plan-zero/zyraxes-rover/README.md

# Zyraxes Rover 

This is a platform that will be used for educational purposes and/or other projects.
This is inspired by the existing [JPL’s rover](https://github.com/nasa-jpl/open-source-rover).
