plan-zero/zyraxes-rover/hw/Schematic_zyraxes-motor-driver-v4.2.pdf

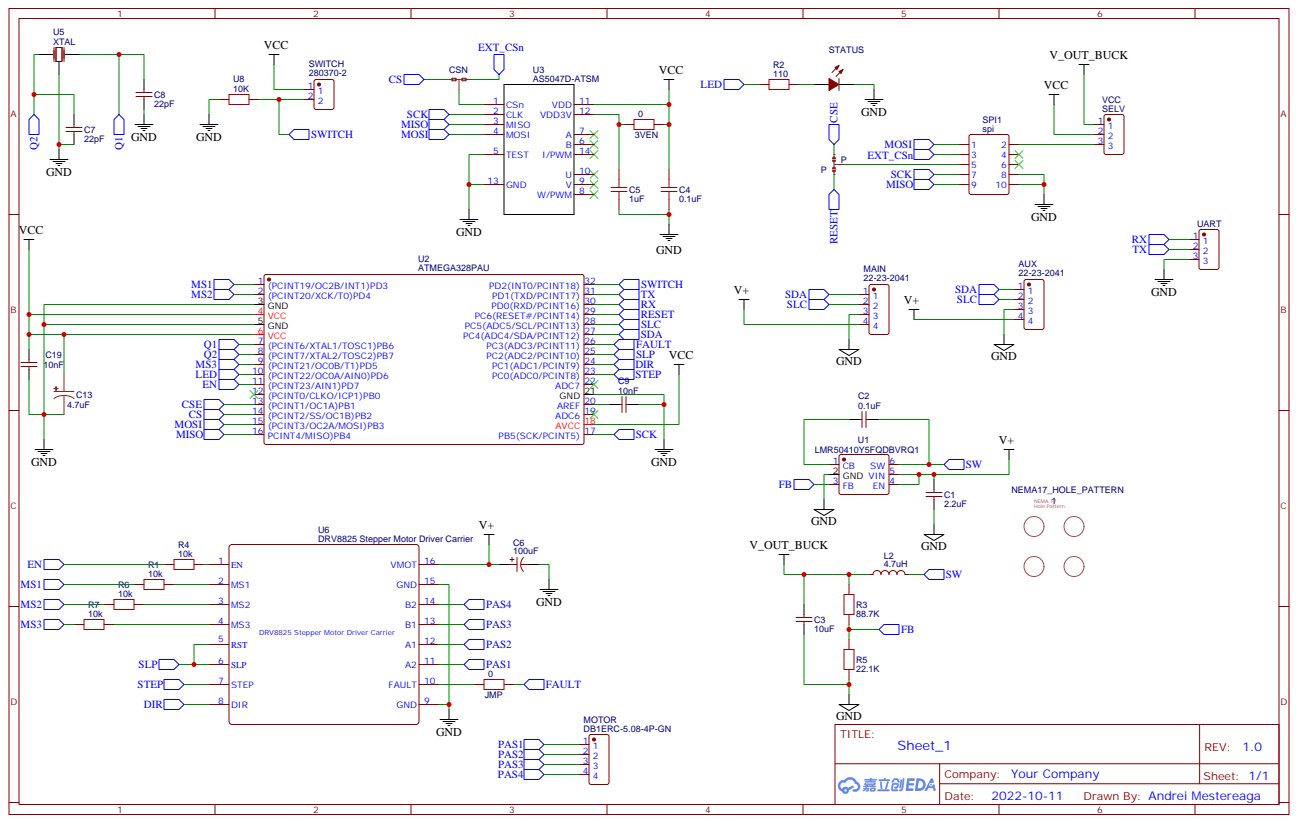
[picture p1: page 1]

DRV8825 Stepper Motor Driver Carrier

Drawn By: Andrei Mestereaga
