plan-zero/zyraxes-rover/hw/Schematic_mechaduino_v1.0.0.pdf

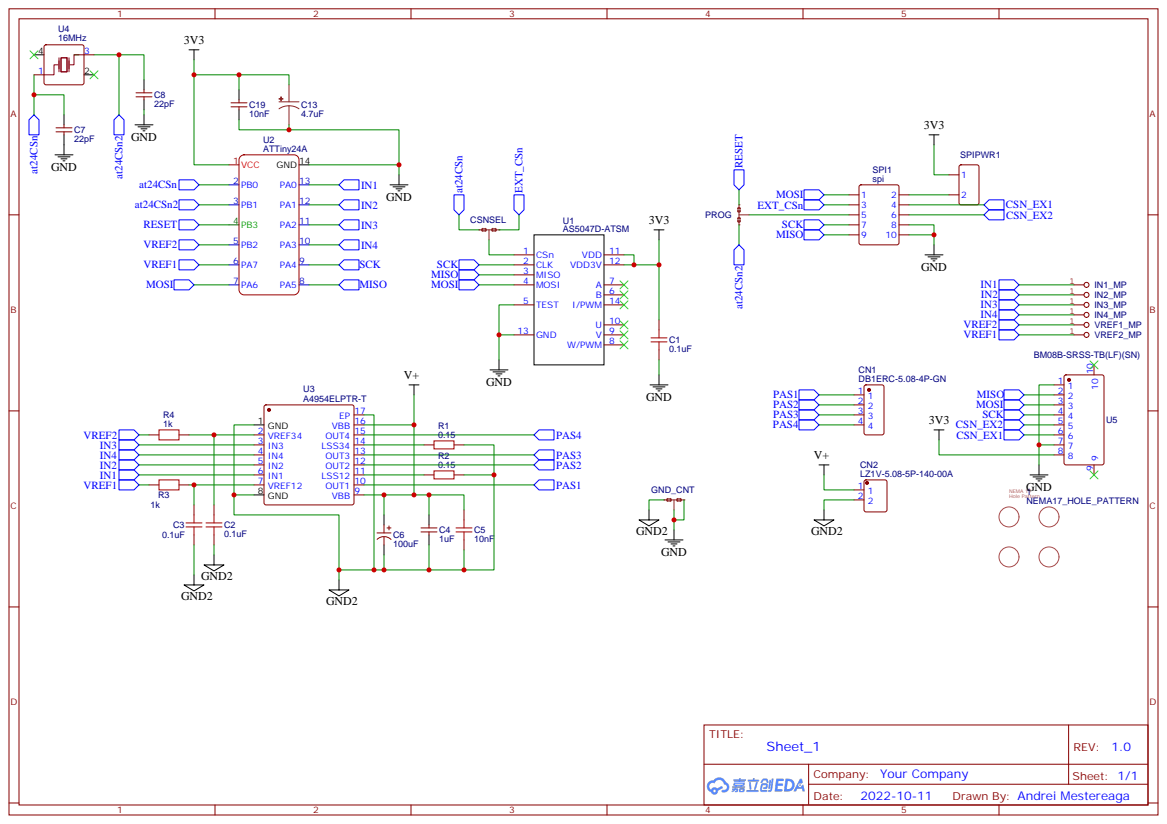
[picture p2: page 1]

BM08B-SRSS-TB(LF)(SN)

Drawn By: Andrei Mestereaga
