plan-zero/zyraxes-rover/hw/Schematic_mechaduino_2022-10-12-1.pdf

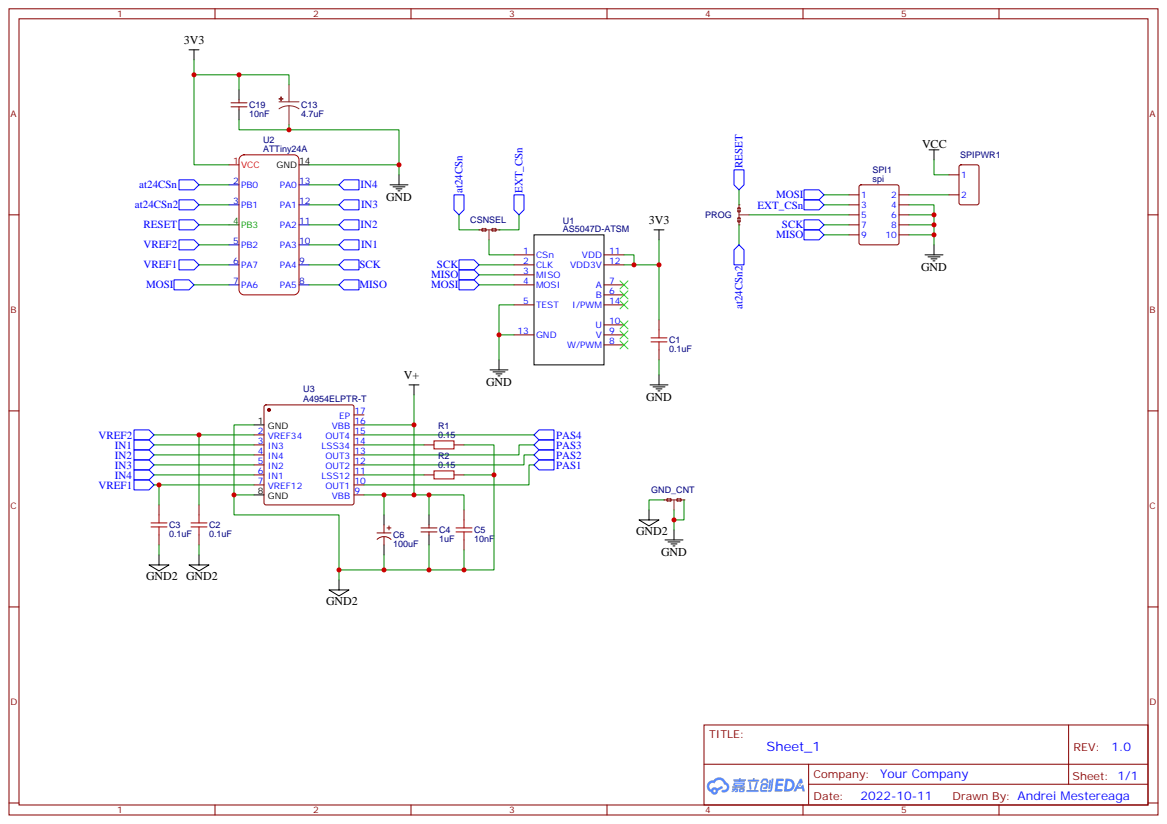
[picture p3: page 1]

Drawn By: Andrei Mestereaga
