plan-zero/zyraxes-rover/hw/powerboard/Schematic_AutomationFarm-powerModule_2022-10-02.pdf

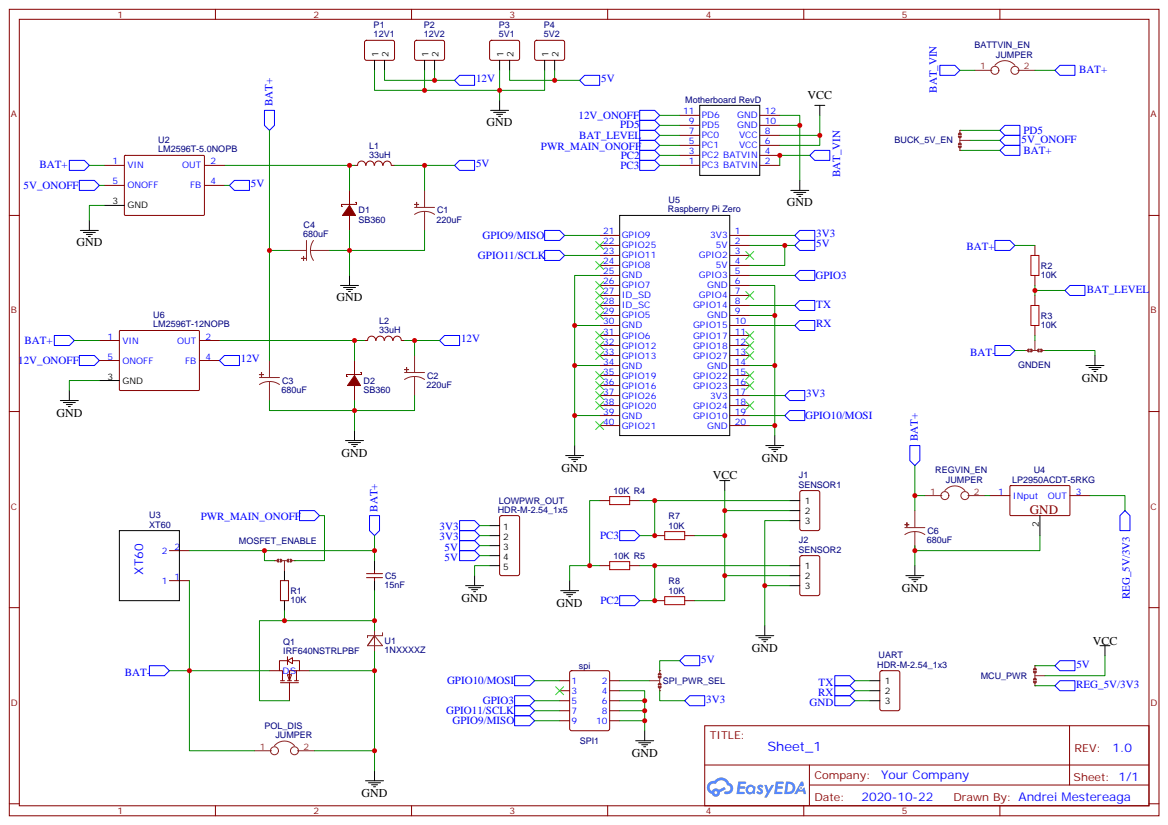
[picture p4: page 1]

Drawn By: Andrei Mestereaga
