plan-zero/zyraxes-rover/hw/Schematic_zyraxes-motor-driver-v3.5.pdf

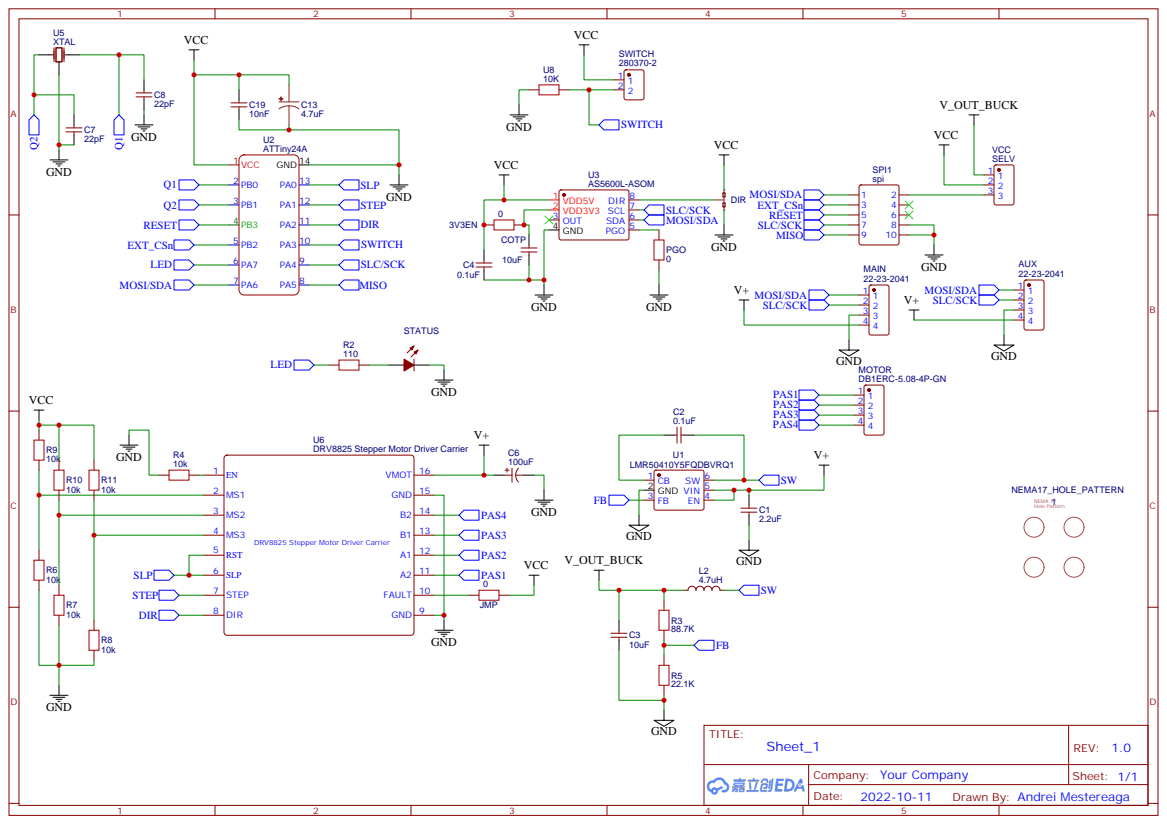
[picture p5: page 1]

DRV8825 Stepper Motor Driver Carrier

Drawn By: Andrei Mestereaga
