plan-zero/zyraxes-rover/hw/Schematic_mechaduino_v0.0.4.pdf

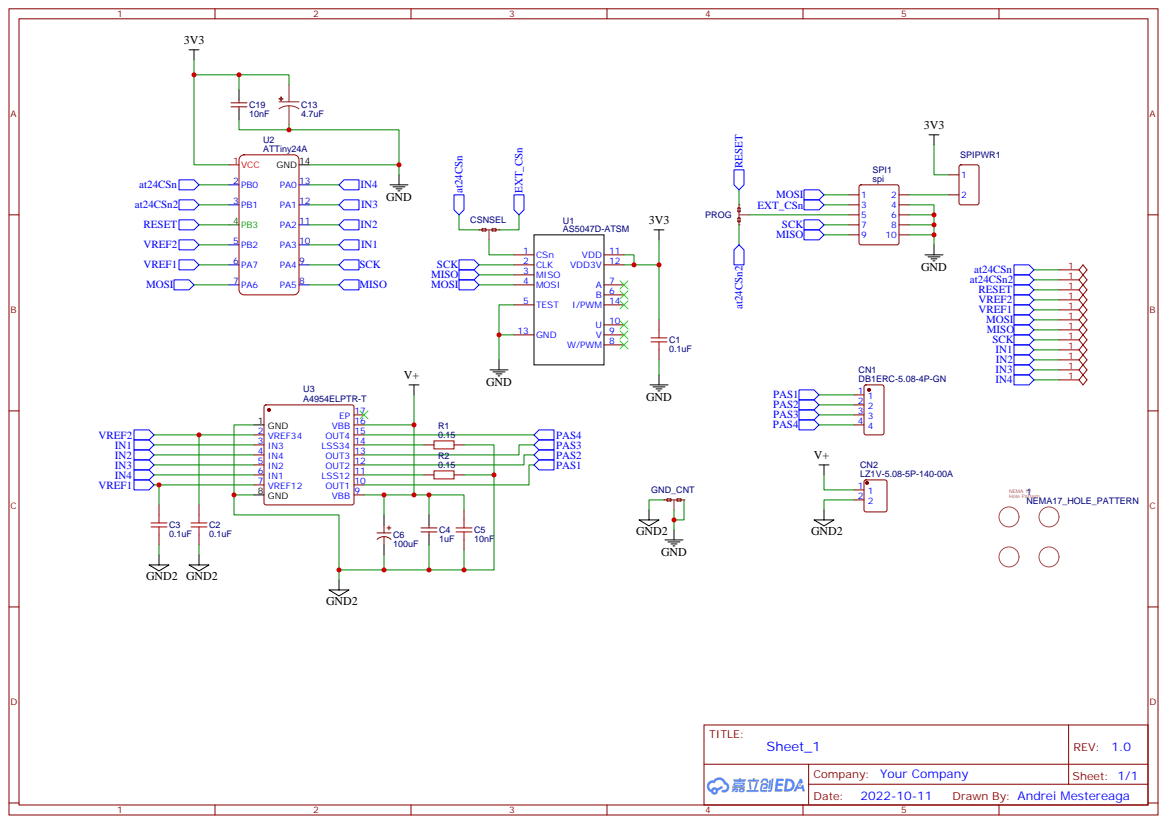
[picture p6: page 1]

Drawn By: Andrei Mestereaga
