plan-zero/zyraxes-rover/hw/Mechaduino-multi/Mechaduino-planzero.kicad_pcb

## KiCad design hw/Mechaduino-multi/Mechaduino-planzero.kicad_pcb (2022-10-27)

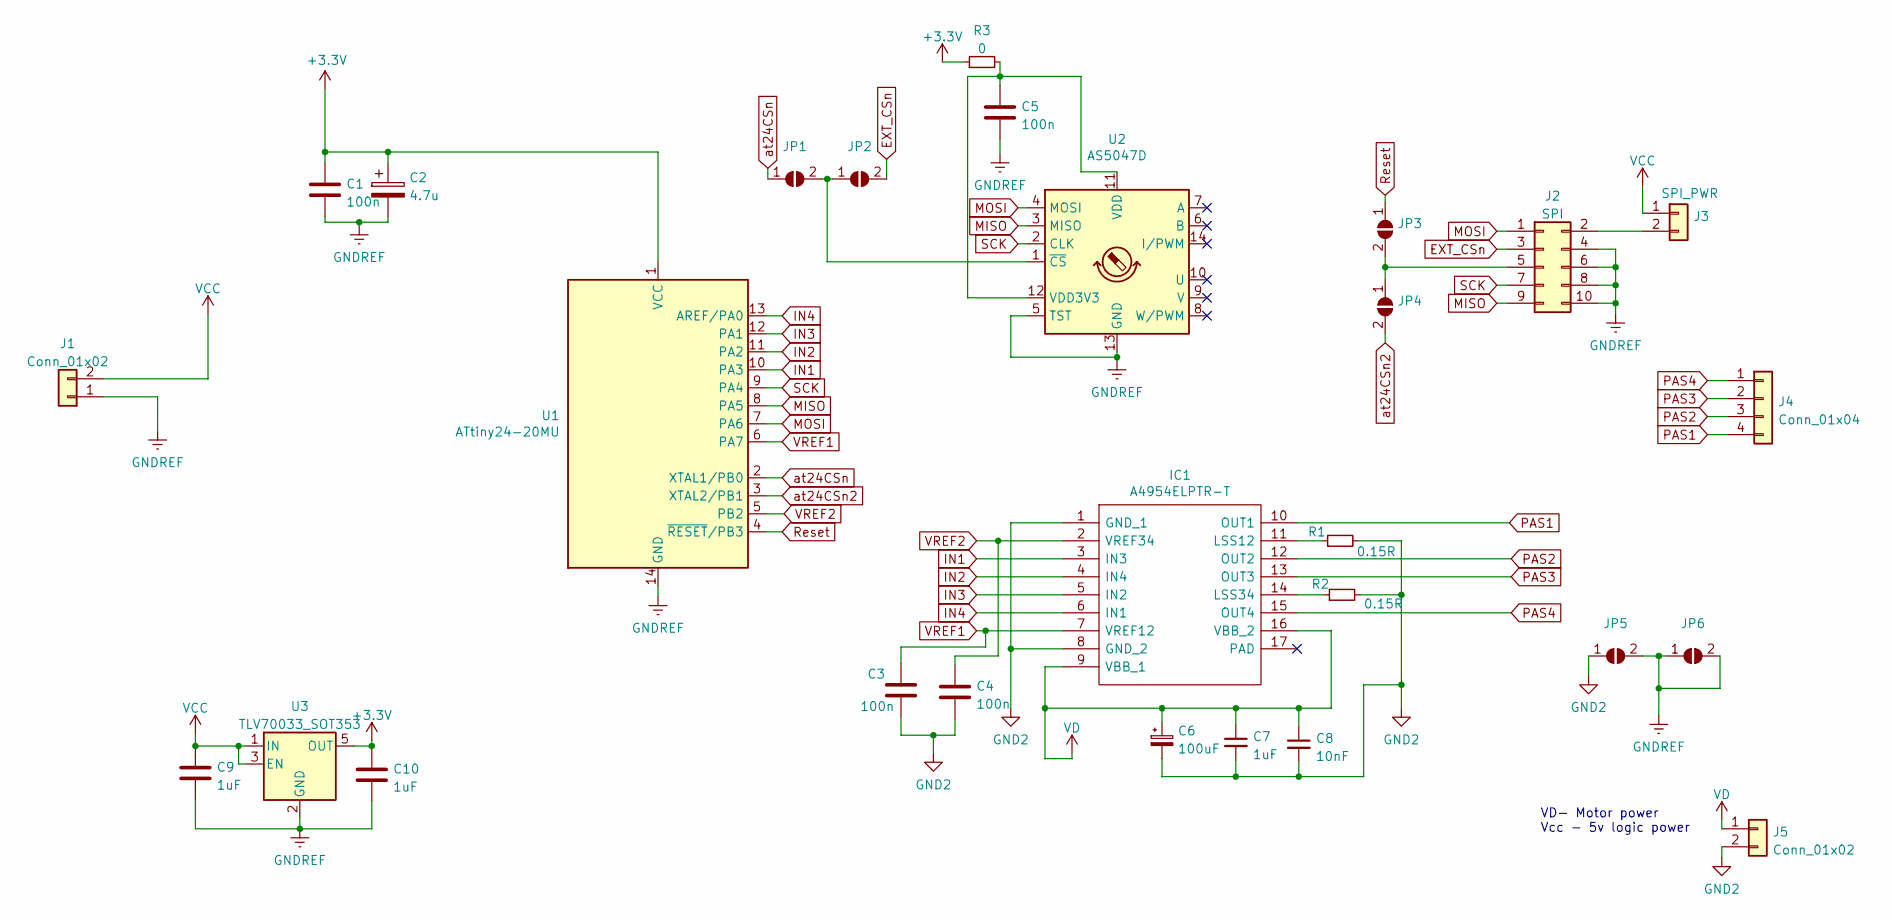
[picture p7: schematic Mechaduino-planzero.kicad_sch]

Parts:
C1, C3, C4, C5: 100n; C_0805_2012Metric_Pad1.18x1.45mm_HandSolder
C2: 4.7u; C_0805_2012Metric_Pad1.18x1.45mm_HandSolder
C6: 100uF; CP_Elec_8x10
C7, C9, C10: 1uF; C_0805_2012Metric_Pad1.18x1.45mm_HandSolder
C8: 10nF; C_0603_1608Metric_Pad1.08x0.95mm_HandSolder
IC1: A4954ELPTR-T; TSSOP-16-1EP_4.4x5mm_P0.65mm_EP3x3mm; Manufacturer_Part_Number A4954ELPTR-T
J1: Conn_01x02; PinSocket_1x02_P2.54mm_Horizontal
J2: SPI; IDC-Header_2x05_P2.54mm_Vertical
J3: SPI_PWR; PinSocket_1x02_P2.54mm_Vertical
J4: Conn_01x04; PinSocket_1x04_P2.54mm_Horizontal
J5: Conn_01x02; TerminalBlock_bornier-2_P5.08mm
JP1, JP2, JP3, JP4, JP5, JP6: SolderJumper-2_P1.3mm_Open_Pad1.0x1.5mm
R1, R2: 0.15R; R_0805_2012Metric_Pad1.20x1.40mm_HandSolder
R3: 0; R_0805_2012Metric_Pad1.20x1.40mm_HandSolder
U1: ATtiny24-20MU; SOIC-14_3.9x8.7mm_P1.27mm
U2: AS5047D; TSSOP-14_4.4x5mm_P0.65mm
U3: TLV70033_SOT353; SOT-353_SC-70-5

Connections:
+3V3: C1.1, C2.1, C10.1, R3.1, U1.1 (VCC), U3.5 (OUT)
EXT_CSn: J2.3, JP2.2 (B)
GND2: C3.2, C4.2, C6.2, C7.2, C8.2, IC1.1 (GND_1), IC1.8 (GND_2), J5.2, JP5.1 (A), R1.2, R2.2
GNDREF: C1.2, C2.2, C5.2, C9.2, C10.2, J1.1, J2.4, J2.6, J2.8, J2.10, JP5.2 (B), JP6.1 (A), JP6.2 (B), U1.14 (GND), U2.5 (TST), U2.13 (GND), U3.2 (GND)
IN1: IC1.3 (IN3), U1.10 (PA3)
IN2: IC1.4 (IN4), U1.11 (PA2)
IN3: IC1.5 (IN2), U1.12 (PA1)
IN4: IC1.6 (IN1), U1.13 (AREF/PA0)
MISO: J2.9, U1.8 (PA5), U2.3 (MISO)
MOSI: J2.1, U1.7 (PA6), U2.4 (MOSI)
unnamed: C5.1, R3.2, U2.11 (VDD), U2.12 (VDD3V3)
unnamed: IC1.11 (LSS12), R1.1
unnamed: IC1.14 (LSS34), R2.1
unnamed: J2.2, J3.2
unnamed: J2.5, JP3.2 (B), JP4.1 (A)
unnamed: JP1.2 (B), JP2.1 (A), U2.1 (~CS)
PAS1: IC1.10 (OUT1), J4.4
PAS2: IC1.12 (OUT2), J4.3
PAS3: IC1.13 (OUT3), J4.2
PAS4: IC1.15 (OUT4), J4.1
Reset: JP3.1 (A), U1.4 (~RESET/PB3)
SCK: J2.7, U1.9 (PA4), U2.2 (CLK)
VCC: C9.1, J1.2, J3.1, U3.1 (IN), U3.3 (EN)
VD: C6.1, C7.1, C8.1, IC1.9 (VBB_1), IC1.16 (VBB_2), J5.1
VREF1: C3.1, IC1.7 (VREF12), U1.6 (PA7)
VREF2: C4.1, IC1.2 (VREF34), U1.5 (PB2)
at24CSn: JP1.1 (A), U1.2 (XTAL1/PB0)
at24CSn2: JP4.2 (B), U1.3 (XTAL2/PB1)

Notes on the sheet:
VD- Motor power Vcc - 5v logic power

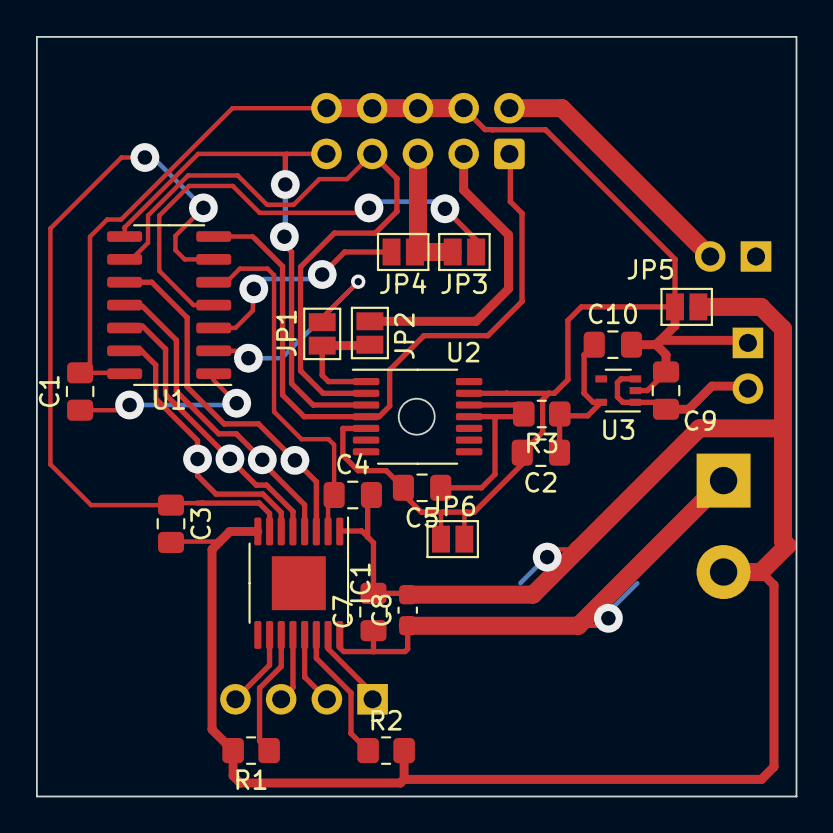
[picture p8: board Mechaduino-planzero.kicad_pcb from above]

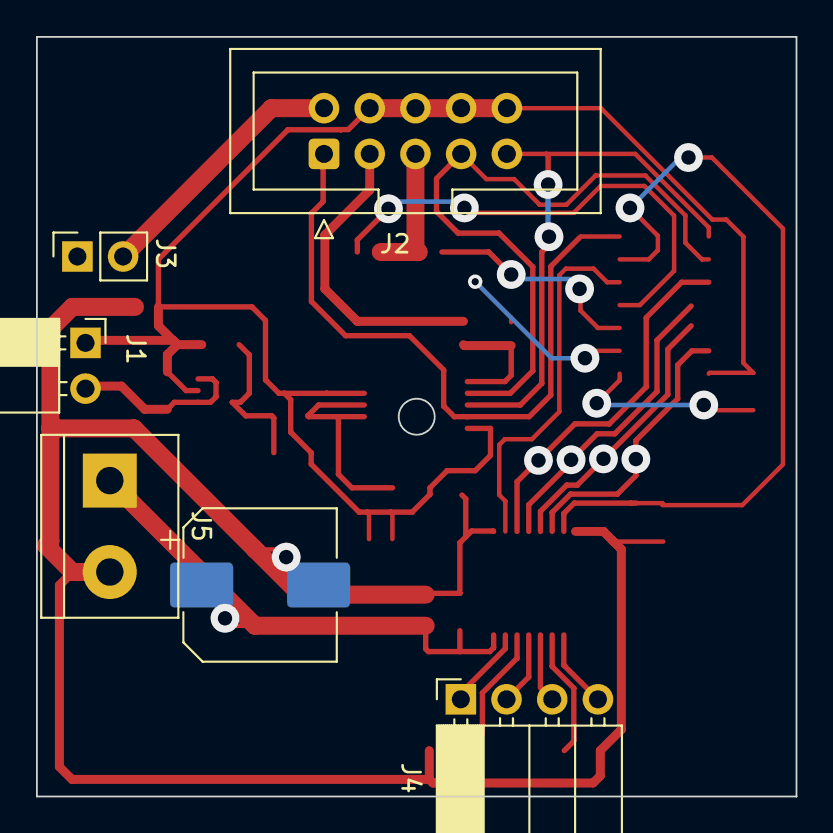
[picture p9: board Mechaduino-planzero.kicad_pcb from below]

Board: 2 copper layers, 42.2 x 42.2 mm, 28 parts (6 on the bottom side), 28 nets.
