plan-zero/zyraxes-rover/sw/src/attiny24/drivers/spi/spi_driver.h

// Copyright (C) 2023 Plan-Zero
// 
// This file is part of automatic-farm.
// 
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

#ifndef SPI_DRIVER_H
#define SPI_DRIVER_H

#define SPI_DATA_SIZE 5
#define SPI_POS_TRANSFER_COMPLETE 4
#define SPI_POS_CHECKSUM_COMPLETE 3
#define SPI_POS_DO_CHECKSUM       2

#define SLAVE_ACK 0xAA

typedef enum {
    SlaveSYNC = 0xAA,
    SlaveSTEP = 0x77,
    SlaveSETUP = 0x78,
    SlaveERROR = 0x55
}SlaveACK;

typedef enum {
    MasterSYNC = 0x3,
    MasterSETUP = 0x2,
    MasterSTEP = 0x1,
    MasterCount
}MasterCMD;

typedef struct  {
	unsigned char transferComplete : 1; //!< True when transfer completed.
    unsigned char doChecksum : 1;
	unsigned char writeCollision : 1;   //!< True if put attempted during transfer.
	unsigned char cs_assert : 1; //!< True if in slaveMode and CS is asserted by master.
    unsigned char master_cmd : 2;
}usidriverStatus_t;

extern volatile unsigned  char spi_received_data[SPI_DATA_SIZE];
extern volatile usidriverStatus_t spiX_status;
extern unsigned char calculated_checksum;


void spiX_initslave(char spi_mode);
char spiX_put(unsigned char val);

#endif /*SPI_DRIVER_H*/
