plan-zero/zyraxes-rover/sw/src/atmega328p/drivers/spi/spi.h

#ifndef SPI_H
#define SPI_H

#include <avr/io.h>
#include "stdint.h"



void spi_tx_8(uint8_t data);
void spi_tx_16(uint16_t data);
uint8_t spi_rx_8(uint8_t data);
uint16_t spi_rx_16(uint16_t data);

void spi_master_init(void);

#endif /*SPI_H*/
