plan-zero/zyraxes-rover/sw/src/atmega328p/firmware/firmware_version.h

#ifndef FIRMWARE_VERSION_H
#define FIRMWARE_VERSION_H

#include "stdint.h"

//this is 1.0.0
#define VERSION_MAJOR (uint8_t)1
#define VERSION_MINOR (uint8_t)1
#define VERSION_PATCH (uint8_t)0


#endif /*FIRMWARE_VERSION_H*/
