plan-zero/zyraxes-rover/sw/src/sam4l_xplained_pro/examples/blinky/main_sam4l.c

/**
 * \file
 *
 * \brief Getting Started Application.
 *
 * Copyright (c) 2012-2018 Microchip Technology Inc. and its subsidiaries.
 *
 * \asf_license_start
 *
 * \page License
 *
 * Subject to your compliance with these terms, you may use Microchip
 * software and any derivatives exclusively with Microchip products.
 * It is your responsibility to comply with third party license terms applicable
 * to your use of third party software (including open source software) that
 * may accompany Microchip software.
 *
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
 * \asf_license_stop
 *
 */

/**
 * \mainpage Getting Started Application
 *
 * \section Purpose
 *
 * The Getting Started example will help new users get familiar with Atmel's
 * SAM family of microcontrollers. This basic application shows the startup
 * sequence of a chip and how to use its core peripherals.
 *
 * \section Requirements
 *
 * This package can be used with SAM4L boards.
 *
 * \section Description
 *
 * The demonstration program makes the on-board LED(LED0) blink at a fixed rate.
 * This rate is generated by using Time tick timer. The blinking can be stopped
 * or restarted by using the push button.
 *
 * \section Usage
 *
 * -# Build the program and download it inside the evaluation board. Atmel
 *    Studio and IAR Embedded Workbench for ARM are available.
 * -# On the computer, open and configure a terminal application
 *    (e.g. HyperTerminal on Microsoft Windows) with these settings:
 *   - 115200 bauds
 *   - 8 bits of data
 *   - No parity
 *   - 1 stop bit
 *   - No flow control
 * -# Start the application.
 * -# The LED should start blinking on the board. In the terminal window, the
 *    following text should appear (values depend on the board and chip used):
 *    \code
	-- Getting Started Example xxx --
	-- xxxxxx-xx
	-- Compiled: xxx xx xxxx xx:xx:xx --
\endcode
 * -# Pressing and releasing the push button should make the first LED stop &
 *    restart blinking.
 *
 */
/*
 * Support and FAQ: visit <a href="https://www.microchip.com/support/">Microchip Support</a>
 */

#include "asf.h"

/** LED0 blink time, in ms */
#define BLINK_PERIOD        1000

#define STRING_EOL    "\r"
#define STRING_HEADER "-- Getting Started Example --\r\n" \
		"-- "BOARD_NAME" --\r\n" \
		"-- Compiled: "__DATE__" "__TIME__" --"STRING_EOL

/** LED0 blinking control. */
volatile uint32_t g_b_led0_active = 1;
/** Global g_ul_ms_ticks in milliseconds since start of application */
volatile uint32_t g_ul_ms_ticks = 0;


/**
 *  \brief Handler for System Tick interrupt.
 *
 *  Process System Tick Event
 *  Increments the g_ul_ms_ticks counter.
 */
void SysTick_Handler(void)
{
	g_ul_ms_ticks++;
}

/**
 * \brief Interrupt handler for EIC interrupt.
 */
static void set_toggle_flag(void)
{
	/* Check if EIC push button line interrupt line is pending. */
	if (eic_line_interrupt_is_pending(EIC, GPIO_PUSH_BUTTON_EIC_LINE)) {
		eic_line_clear_interrupt(EIC, GPIO_PUSH_BUTTON_EIC_LINE);
		g_b_led0_active = !g_b_led0_active;
		if (!g_b_led0_active) {
			LED_Off(LED0);
		}
	}
}

/**
 *  Interrupt handler for TC00 interrupt.
 */
void TC00_Handler(void)
{
	volatile uint32_t ul_dummy;

	/* Clear status bit to acknowledge interrupt */
	ul_dummy = tc_get_status(TC0, 0);

	/* Avoid compiler warning */
	UNUSED(ul_dummy);

	printf("2 ");
}

/**
 * \brief Configure UART console.
 */
static void configure_console(void)
{
	const usart_serial_options_t uart_serial_options = {
		.baudrate = CONF_UART_BAUDRATE,
#ifdef CONF_UART_CHAR_LENGTH
		.charlength = CONF_UART_CHAR_LENGTH,
#endif
		.paritytype = CONF_UART_PARITY,
#ifdef CONF_UART_STOP_BITS
		.stopbits = CONF_UART_STOP_BITS,
#endif
	};

	/* Configure console UART. */
	stdio_serial_init(CONF_UART, &uart_serial_options);
}


/**
 * Configure push button 0 to generate an EIC interrupt.
 */
static void configure_button(void)
{
	struct eic_line_config eic_line_conf;

	eic_line_conf.eic_mode = EIC_MODE_EDGE_TRIGGERED;
	eic_line_conf.eic_edge = EIC_EDGE_FALLING_EDGE;
	eic_line_conf.eic_level = EIC_LEVEL_LOW_LEVEL;
	eic_line_conf.eic_filter = EIC_FILTER_DISABLED;
	eic_line_conf.eic_async = EIC_ASYNCH_MODE;

	eic_enable(EIC);
	eic_line_set_config(EIC, GPIO_PUSH_BUTTON_EIC_LINE,
		&eic_line_conf);
	eic_line_set_callback(EIC, GPIO_PUSH_BUTTON_EIC_LINE, set_toggle_flag,
		GPIO_PUSH_BUTTON_EIC_IRQ, 1);
	eic_line_enable(EIC, GPIO_PUSH_BUTTON_EIC_LINE);
}

/**
 *  Configure Timer Counter 0 to generate an interrupt every 200ms.
 */
static void configure_tc(void)
{
	uint32_t ul_div;
	uint32_t ul_tcclks;
	uint32_t ul_sysclk = sysclk_get_cpu_hz();

	/* Configure TC0 */
	sysclk_enable_peripheral_clock(TC0);

	/* Configure TC for a 5Hz frequency and trigger on RC compare. */
	if (!tc_find_mck_divisor(5, ul_sysclk, &ul_div, &ul_tcclks, ul_sysclk)) {
		puts("No valid divisor found!\r");
		return;
	}
	tc_init(TC0, 0, ul_tcclks | TC_CMR_CPCTRG);
	tc_write_rc(TC0, 0, (ul_sysclk / ul_div) / 5);

	/* Configure and enable interrupt on RC compare */
	NVIC_EnableIRQ((IRQn_Type) TC00_IRQn);
	tc_enable_interrupt(TC0, 0, TC_IER_CPCS);

	/* Start the counter. */
	tc_start(TC0, 0);
}

/**
 *  Waits for the given number of milliseconds (using the g_ul_ms_ticks
 *  generated by the SAM's microcontrollers's system tick).
 *  \param ul_dly_ticks  Delay to wait for, in milliseconds.
 */
static void mdelay(uint32_t ul_dly_ticks)
{
	uint32_t ul_cur_ticks;

	ul_cur_ticks = g_ul_ms_ticks;
	while ((g_ul_ms_ticks - ul_cur_ticks) < ul_dly_ticks);
}

/**
 *  \brief getting-started Application entry point.
 *
 *  \return Unused (ANSI-C compatibility).
 */
int main(void)
{
	/* Initialize the SAM system */
	sysclk_init();
	board_init();

	/* Initialize the console uart */
	configure_console();

	/* Output example information */
	puts(STRING_HEADER);

	/* Configure systick for 1 ms */
	puts("Plan Zero blinky example \r\n");
	puts("Configure system tick to get 1ms tick period.\r");
	if (SysTick_Config(sysclk_get_cpu_hz() / BLINK_PERIOD)) {
		puts("-F- Systick configuration error\r");
		while (1);
	}

	puts("Configure button.\r");
	configure_button();
	puts("Configure TC.\r");
	configure_tc();

	printf("Press %s to Start/Stop LED0 blinking.\r\n", BUTTON_0_NAME);

	while (1) {
		/* Wait for LED to be active */
		while (!g_b_led0_active);

		/* Toggle LED state if active */
		if (g_b_led0_active == 1) {
			LED_Toggle(LED0);
			printf("1 ");
		}

		/* Wait for 500ms */
		mdelay(500);
	}
}
