plan-zero/zyraxes-rover/(commit log)

2022-10-02 Add schematic for power board
2022-10-16 Add initial sch & libs for mechaduino multi
    [Mechaduino-planzero.kicad_pcb, Mechaduino-planzero.sch]
2022-10-22 update schematic
    [Mechaduino-planzero.kicad_sch]
2022-10-22 update pcb layout
    [Mechaduino-planzero.kicad_pcb]
2022-10-26 Some updates
    [Mechaduino-planzero.kicad_pcb]
2022-10-27 Add new updates to driver sch / layout
    [Mechaduino-planzero.kicad_pcb, Mechaduino-planzero.kicad_sch]
2022-10-27 Remove unused kicad files
    [Mechaduino-planzero.sch]
2023-11-26 Add schematic v0.0.4
2024-01-09 [SW] Add initial SAM4L/SAMD21 board code - ASF
2024-01-09 [SW] Add SPI driver for attiny24; add examples for SPI and stepepr
2024-01-09 [SW] Add spi example for SAM4L
2024-01-09 [SW] Fix blinky example
    [main_sam4l.c]
2024-01-11 [SW] Add 4MHZ SPI config
2024-01-14 [SW] Add support for Fixed PCS selection
    [zyraxes_firmware.c]
2024-01-15 [SW] Enable decmode SPI
2024-01-15 [SW] Add NPCS3 as SPI CS
2024-01-22 [SW] Fix encoder read for 8bits
    [zyraxes_firmware.c]
2024-01-25 [SW] Disable/enable MOSI pin from t24 between SPI transfers
2024-01-25 [SW] Add PWM control via SPI
2024-01-25 [SW] Add motor control - working version
2024-02-04 [SW] Change SPI driver CS to PB0
2024-02-04 [SW] Add 1/32 step as motor example using sin
2024-02-13 [HW] Add schematic for v1.0.0
2024-03-18 Update schematic for v1.0.0
2024-04-01 [SW] Use new method for motor driver
2024-04-01 [SW] Add calibration routine - mechaduino version
2024-04-01 [SW] Add angle read form magnetic senzor routine
2024-04-01 [SW] Add method to reduce encoder resolution to save flash memory
2024-04-02 [SW] Add timmer interrupt handler at 6.5kHZ
2024-04-03 [SW] Improve motor control by doing multiple steps as once
2024-04-09 [SW] Add checkpoint code - improves in stepper demo
2024-04-10 [SW] Reset page number after calibration
    [motor.c, nvm.h]
2024-04-10 [SW] change motor dir for calibration
2024-04-11 [SW] Add motor status
2024-04-11 [SW] Add other PCs for motors/sensor
2024-04-12 [SW] Switching to SW CS which allows broadcasting on motors
2024-04-12 [SW] Add progress for motor loop control
2024-04-16 [SW] Fix rot variable
    [motor.c, motor.h]
2024-06-06 [SW] Add retry cmd for motors
2024-06-06 [SW] Fix motor sync routine
    [motor.c]
2024-06-06 [SW] Change SPI config
2024-06-12 [SW] Add abs angle for dir motors
2024-06-12 [SW] Add motor dir control test1
2024-06-19 [SW] Add motor stop command in firmware; fix bugs
    [firmware.c, motor.c, motor.h, zyraxes_firmware.c]
2024-11-07 [SW] Add current progress
2025-02-25 Add schematic file for motor driver v4.2
2025-02-25 Add schematic for zyraxes motor driver v3.5
2025-03-17 [SW] Add stepper demo for attiny24 v2 board
2025-03-17 [SW] Add initial stepper demo for atmega328p
2025-03-20 [SW] Add motor control for m328p firmware
2025-03-21 [SW] Add first SPI example atmega-magnetic sensor - working version
2025-03-21 [SW] Fix startup comunication error of magnetic sensor
    [spi.c, spi.h, spi_example.c]
2025-03-21 [SW] Fix rx/tx byte problem
    [spi.c]
2025-03-21 [SW] Add mangetic sensor readings
2025-03-21 [SW] Add few fixes for motor spi comm
    [motor.c, zyraxes_firmware.c]
2025-03-21 [SW] Add basic commands for the motor
2025-03-28 [SW] Refactoring: split motor functions in two categories, SPI and TWI
2025-03-28 [SW] Refactoring: add implementation for TWI motor driver
2025-03-31 [SW] Add end switch feature for v2 atmega328p
2025-05-15 [SW] Add working version - using driver v4.2
2025-06-09 [SW] Fix cmd bug when force stop
    [firmware_m328p.c]
